flekilloloko/genSin/README.md

# genSin
generador sinusoidal hasta 1MHz, utilizando el integrado AD9850
