flekilloloko/genSin/amplitud salida/dds output circuit.png

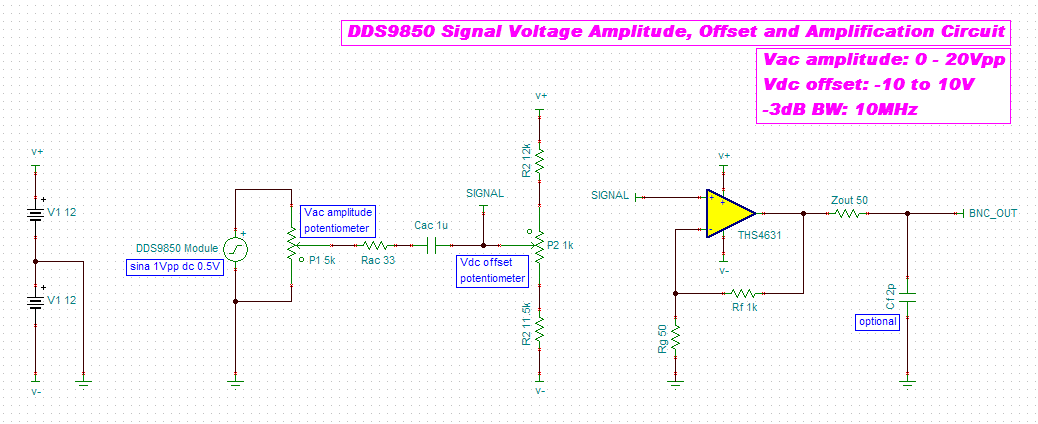
amplitud salida/dds output circuit.png
