flekilloloko/genSin/amplitud salida/Offset_Amplitude.PNG

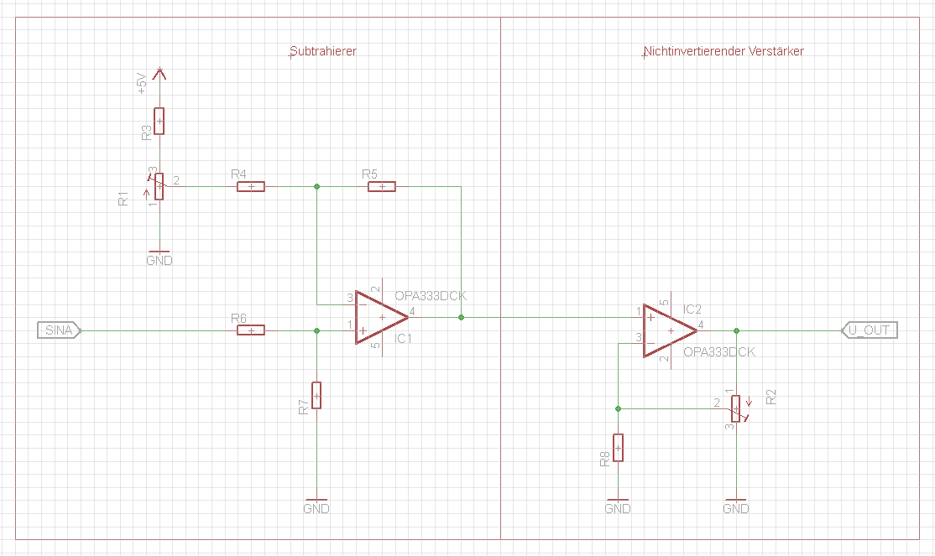
amplitud salida/Offset_Amplitude.PNG
