flekilloloko/genSin/amplitud salida/Output Stage.PNG

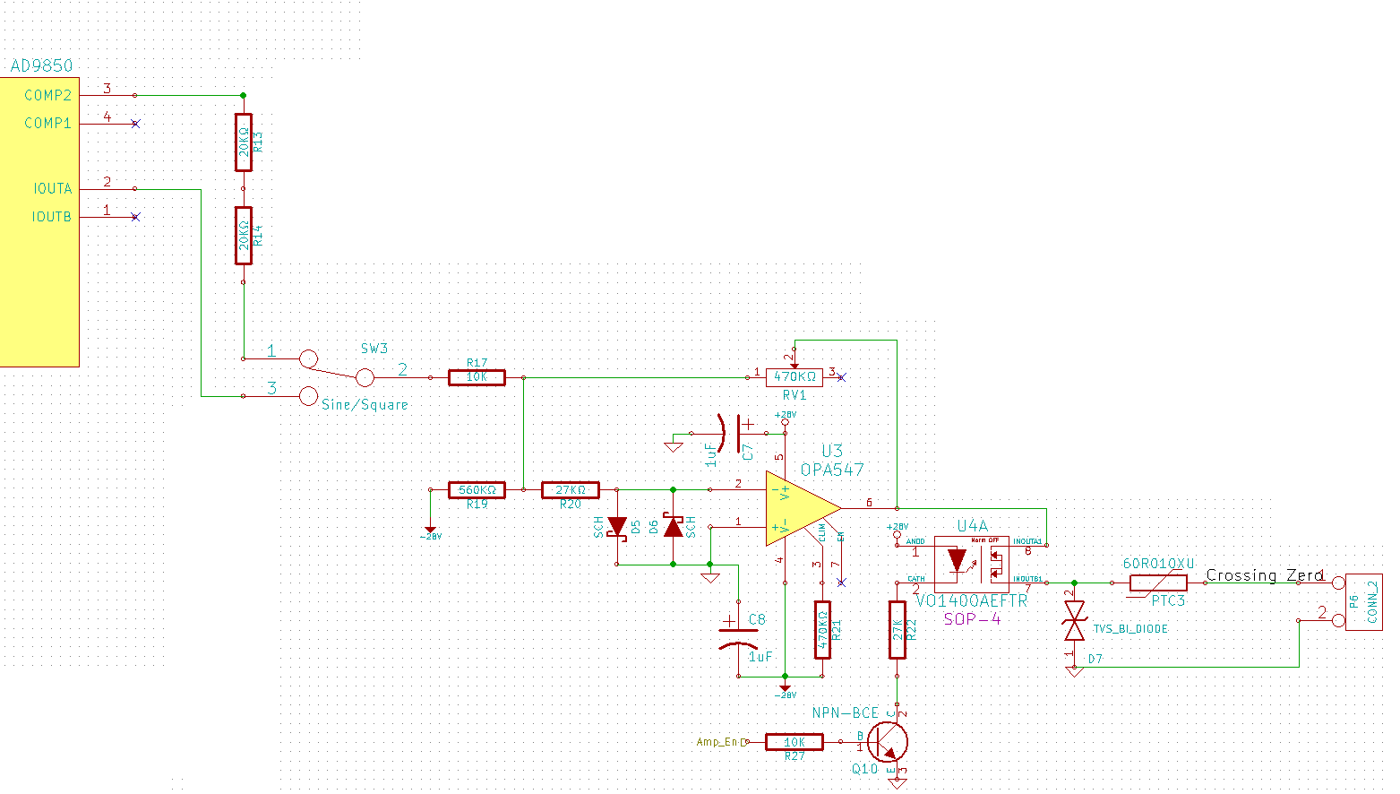
amplitud salida/Output Stage.PNG
