flekilloloko/genSin/amplitud salida/placa/amplitud salida.jpg

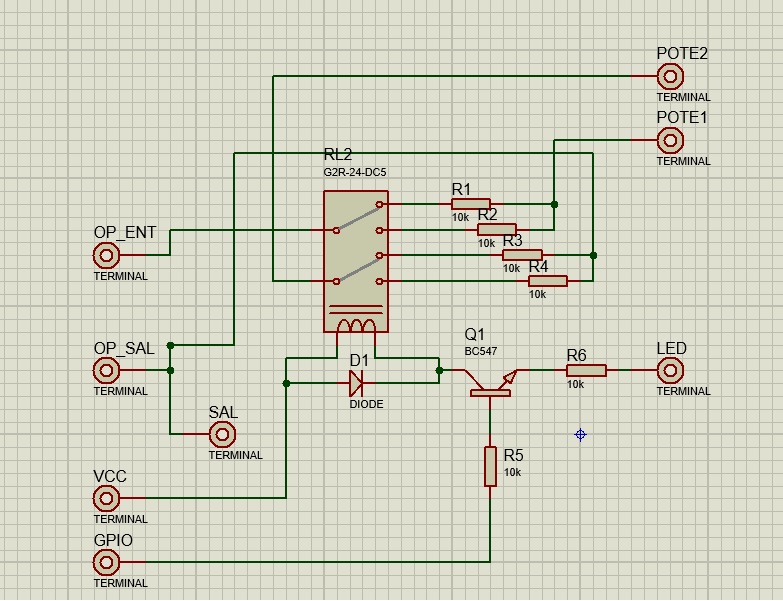
amplitud salida/placa/amplitud salida.jpg
