flekilloloko/genSin/proteus/Cobre.pdf

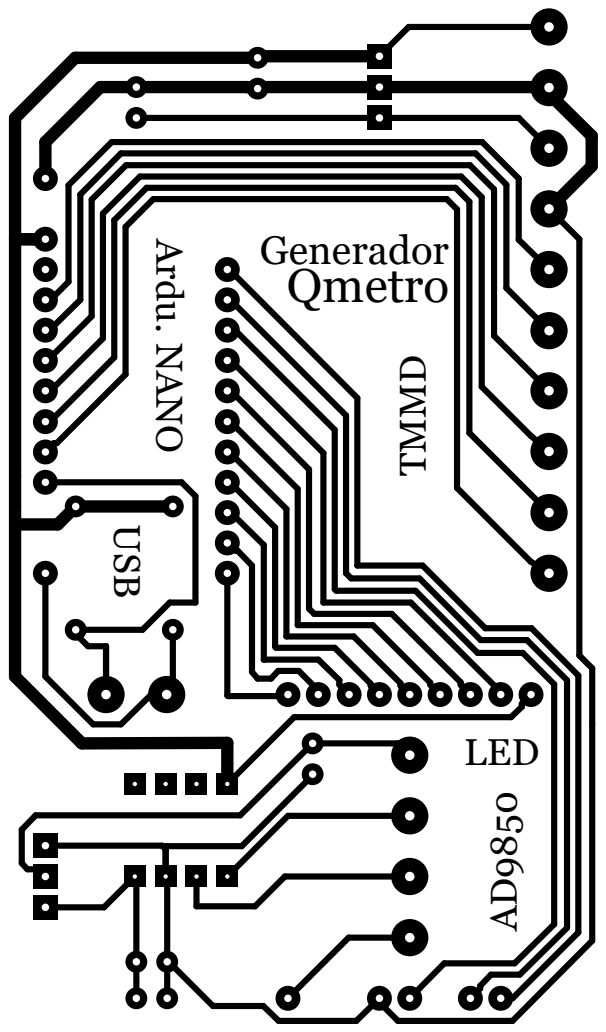
[picture p10: page 1]
Qmetro; GeneradorTMMD Ardu. NANO USB; AD⁹⁸⁵⁰; LED
