flekilloloko/genSin/proteus/Negativo Actualizado.PDF

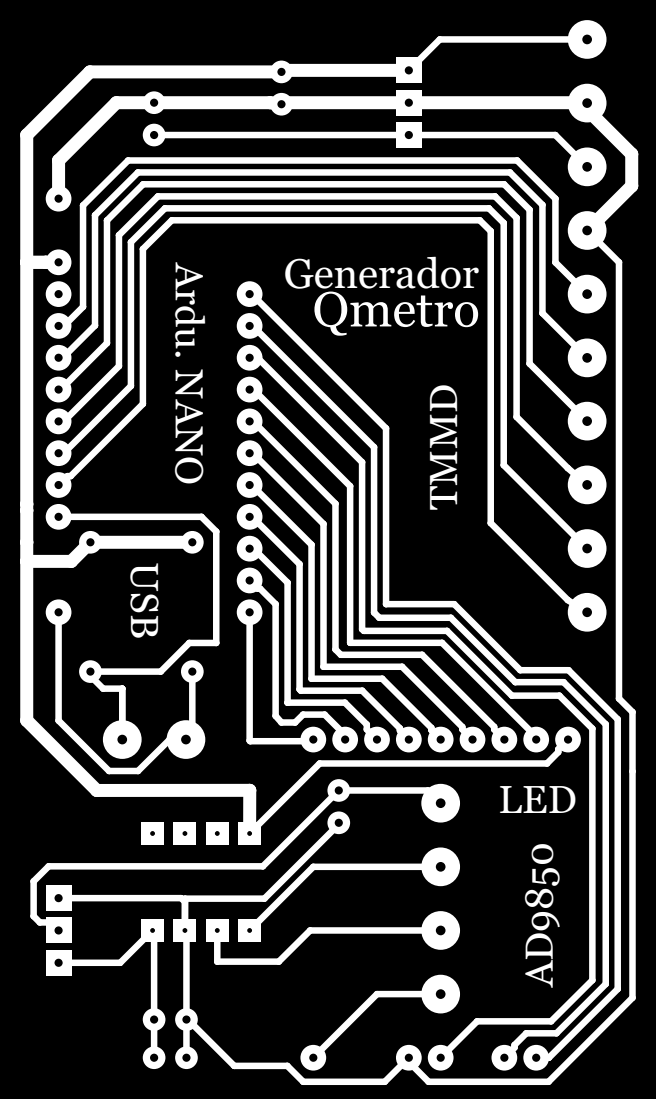
[picture p11: page 1]
