flekilloloko/genSin/proteus/Negativo.PDF

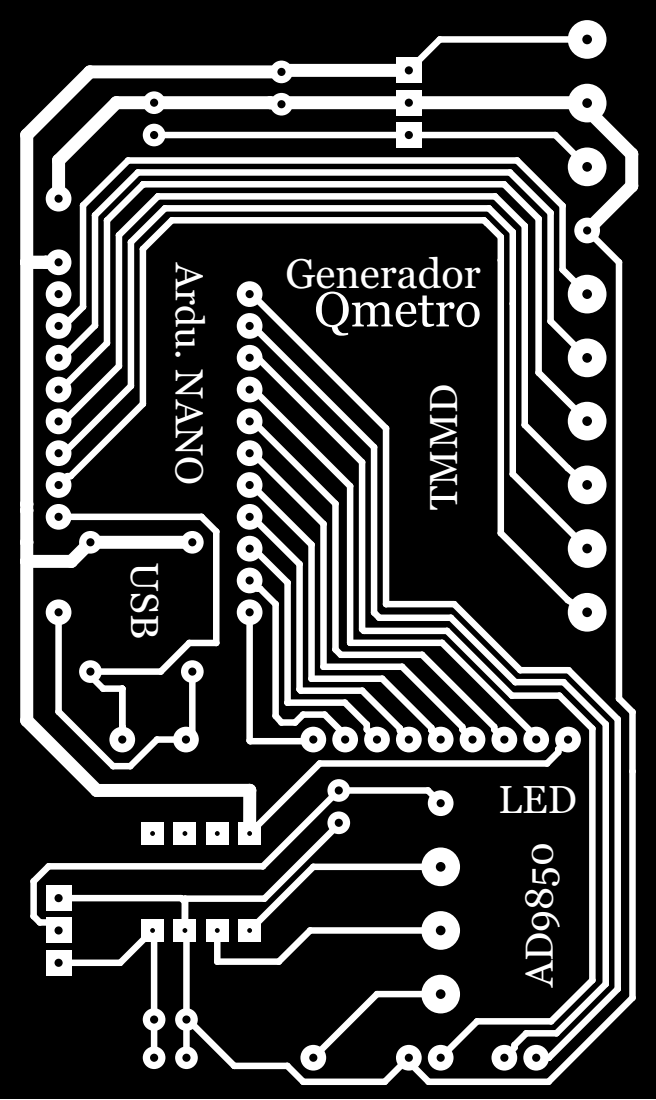
[picture p12: page 1]
