flekilloloko/genSin/proteus/Placa Silk.pdf

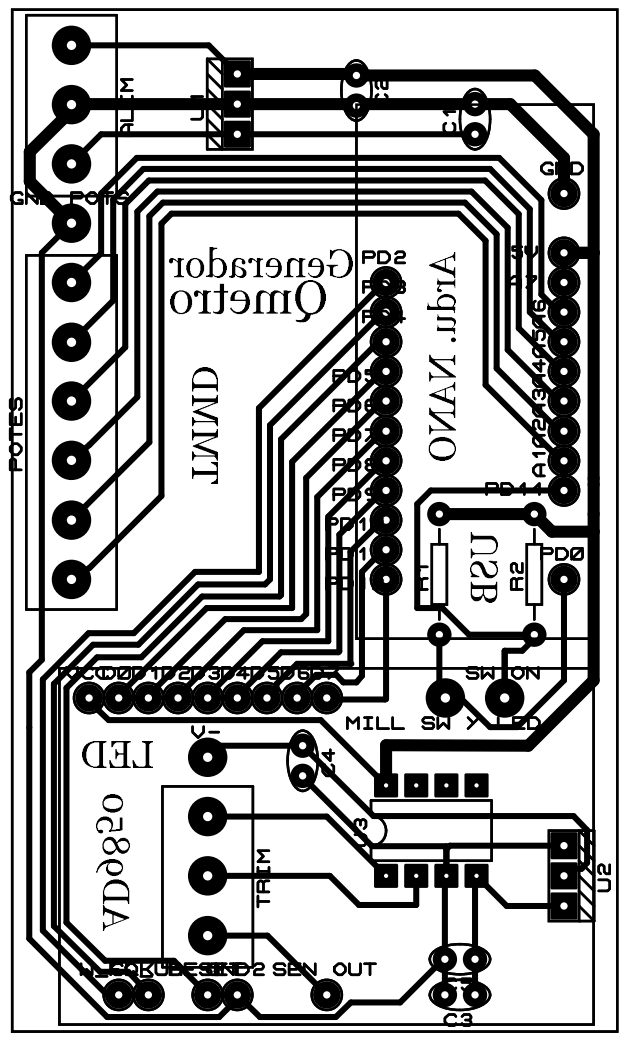
[picture p13: page 1]
