flekilloloko/genSin/proteus/Solo silk.pdf

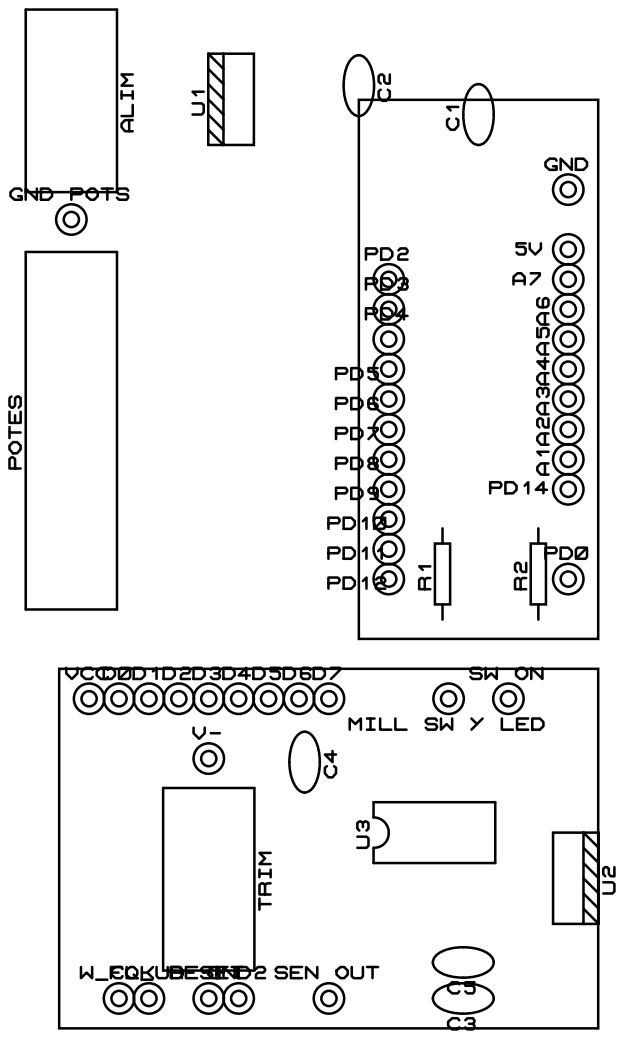
[picture p14: page 1]
