flekilloloko/genSin/amplitud salida/placa/salida silk.pdf

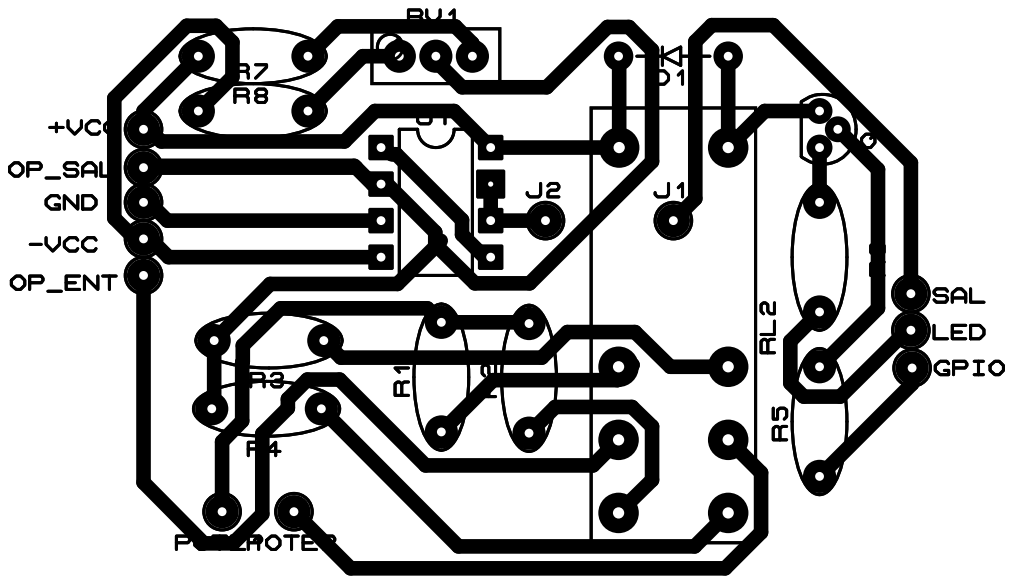
[picture p15: page 1]
