flekilloloko/genSin/amplitud salida/placa/salida generador.pdf

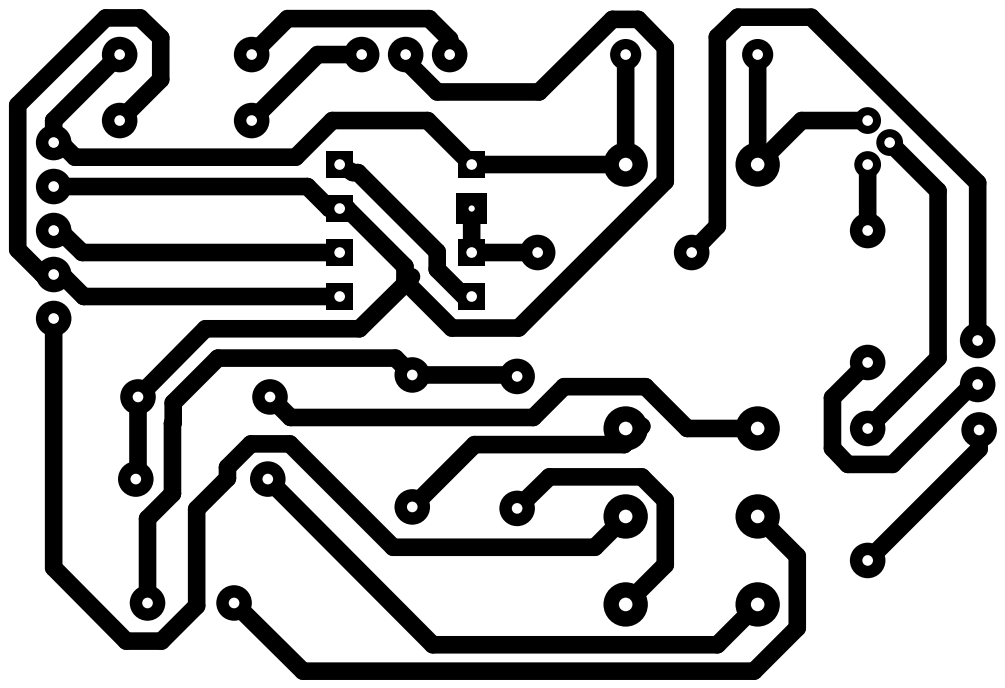
[picture p16: page 1]
