flekilloloko/genSin/(list of files, drawings)

Other design files:
amplitud salida/placa/salida generador.pdsprj
proteus/genQmetro.pdsprj
