flekilloloko/genSin/(commit log)

2017-04-17 Primer commit, txt de requisitos
2017-04-18 Añadidos hoja de datos y programa inicial
2017-05-15 actualizado a la placa
    [genQmetro.pdsprj]
2017-05-17 Diseño de placa finalizado
    [genQmetro.pdsprj]
2017-05-25 Arreglado la resolucion y los potes
    [gen_sin.ino]
2017-05-26 Inicio de informe sumado
2017-05-27 Agregados TODOS los potes y emprolijando
    [genQmetro.pdsprj]
2017-06-07 Agregado de libreria
2017-06-16 agregado led y switch de millones
2017-07-02 plaqueta amplitud salida agregada (esquematico)
    [salida generador.pdsprj]
2017-07-06 Calibrado, comentado lo q falta conectar, CAMBIO DE NOMBRE ARCHIVO para comodida de ejecucion
2017-07-06 INFORME especificada la alimentacion
2017-07-07 Añadido pcb de amplitud
    [salida generador.pdsprj]
2017-07-07 Acomodados pines
    [salida generador.pdsprj]
2017-07-10 Añadido pdf silk amp salida
    [salida generador.pdsprj]
2017-07-17 agregada imagen placa amplitud al informe
    [salida generador.pdsprj]
2017-07-17 Llegando a la versión final del informe
2017-07-17 Añadido formato y solucionador en el informe
2017-08-09 corregido el pin de pwr
    [salida generador.pdsprj]
